houston47d/AntiFreeze/(commit log)

2017-01-28 VERSION 1.4 - SRAM use reduction (to make room for the RTC), zone1Active only looks at thermostat calls. VERSION 1.3 - addition of logging parameters, real-time-clock. VERSION 1.2 - restructuring of 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
    [AntiFreeze.ino, Monitor.ino, TestScript.ino, Utilities.ino]
2017-02-01 Correct default defines, format of Error message
    [AntiFreeze.ino, Monitor.ino]
2017-02-07 Correct monitor invokation when using sleep.
    [AntiFreeze.ino, Monitor.ino, Utilities.ino]
2017-02-07 Change filename to YYMMDDxx.csv. USE_RTC now controls whether we use an RTC that is there (not whether the code exists). processMonitorTimer now run at end of setup. If USE_SLEEP, then only on interr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
2017-02-09 Reworked leds so they only flash for 10 seconds following a state change (generally triggered by a button push).
    [AntiFreeze.ino]
2017-02-09 Further integration of sleep. Time updated on each cycle, not in processMonitorTimer. Test script uses seconds for longer intervals. Test script flags IO expander state using flag (as it did for butt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
2017-02-09 Switch from the sleep library to direct use of the sleep.h file so I have better control over interrupts. USE_SLEEP now works with DIAG_STANDALONE.
2017-02-11 Reworked call timers to work in seconds (were broken back when SimpleTimer was changed to use 16-bit delays). zone2[Really]NeedsCall reworked to use timers rather than calculation each time processMo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
    [AntiFreeze.ino, Monitor.ino]
2017-03-18 Final intergration of Wdt and Sleep (standby). Blink red led each sleep cycle. Disable purge mode selection (code is still there). Resolve warnings due to elevated compiler setting.
    [AntiFreeze.ino, Monitor.ino, Utilities.ino]
